MalteP/klingelerweiterung/documentation/belegung.png

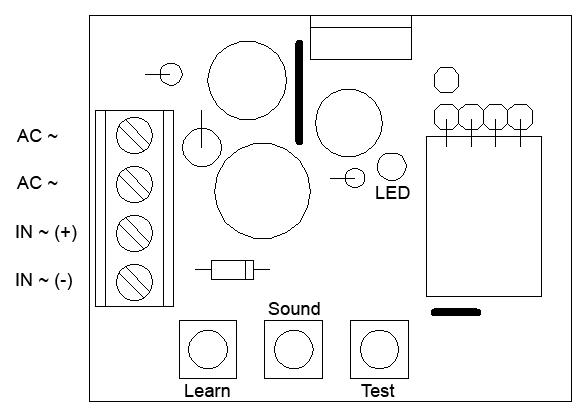
documentation/belegung.png
