MalteP/klingelerweiterung/documentation/Bauteileliste - Klingelerweiterung.ods

Bauteil | Bauteilbezeichnung | Bestellnummer | Distributor | Preis
BR1 | Brückengleichrichter | B40C1500RUND | Reichelt | 0,14 €
C1 | 470µF / 25V | RAD 105 470/63 | Reichelt | 0,17 €
C2 | 100nF SMD 1206 | X7R-G1206 100N | Reichelt | 0,10 €
C3 | 100nF SMD 1206 | X7R-G1206 100N | Reichelt | 0,10 €
C4 | 100µF / 16V | RAD 105 100/35 | Reichelt | 0,04 €
C5 | 100nF SMD 1206 | X7R-G1206 100N | Reichelt | 0,10 €
C6 | 100nF SMD 1206 | X7R-G1206 100N | Reichelt | 0,10 €
C7 | 100nF SMD 1206 | X7R-G1206 100N | Reichelt | 0,10 €
D1 | Zener 1,3W 5,6V | ZD 5,6 | Reichelt | 0,06 €
D2 | P6KE24CA | 543-8450 | RS-Components | 0,81 €
D3 | 1N4007 | 1N 4007 | Reichelt | 0,02 €
D4 | LED blau 3mm | LED 3MM ST BL | Reichelt | 0,58 €
IC1 | MC7805 | TS 7805 CZ | Reichelt | 0,29 €
IC2 | PC357 SMD | PC 357N1TJ00F | Reichelt | 0,32 €
IC3 | ATMega48 | ATMEGA 48A-AU | Reichelt | 1,90 €
IC4 | Sendemodul QAM-TX1 | 617-2072 | RS-Components | 5,75 €
K1 | Schraubklemme 4 fach | AKL 101-04 | Reichelt | 0,39 €
R1 | 680R 1206 | SMD 1/4W 680 | Reichelt | 0,10 €
R2 | 220R 1206 | SMD 1/4W 220 | Reichelt | 0,10 €
R3 | 4,7K 1206 | SMD 1/4W 4,7K | Reichelt | 0,10 €
R4 | 4,7K 1206 | SMD 1/4W 4,7K | Reichelt | 0,10 €
R5 | 4,7K 1206 | SMD 1/4W 4,7K | Reichelt | 0,10 €
R6 | 10R Metallfilm 0,6W | METALL 10,0 | Reichelt | 0,08 € | ← In Schrumpfschlauch, Sicherheitswiderstand!
R7 | 680R 1206 | SMD 1/4W 680 | Reichelt | 0,10 €
R8 | 4,7K 1206 | SMD 1/4W 4,7K | Reichelt | 0,10 €
S1 | Microtaster | TASTER 3301 | Reichelt | 0,10 €
S2 | Microtaster | TASTER 3301 | Reichelt | 0,10 €
S3 | Microtaster | TASTER 3301 | Reichelt | 0,10 €
PCB | Platine | PCB-FUNKGONG | MP | 7,50 €
DB | Distanzbolzen | DI 10MM | Reichelt | 0,40 €
ISO | Isolierscheiben | - | MP | 0,20 € | ← 4 St.
SCH | Schraube M3 | SKL M3X10-50 | Reichelt | 0,20 € | ← 4 St.
 |  |  |  | 20,35 €
