MalteP/klingelerweiterung/documentation/schaltplan.pdf

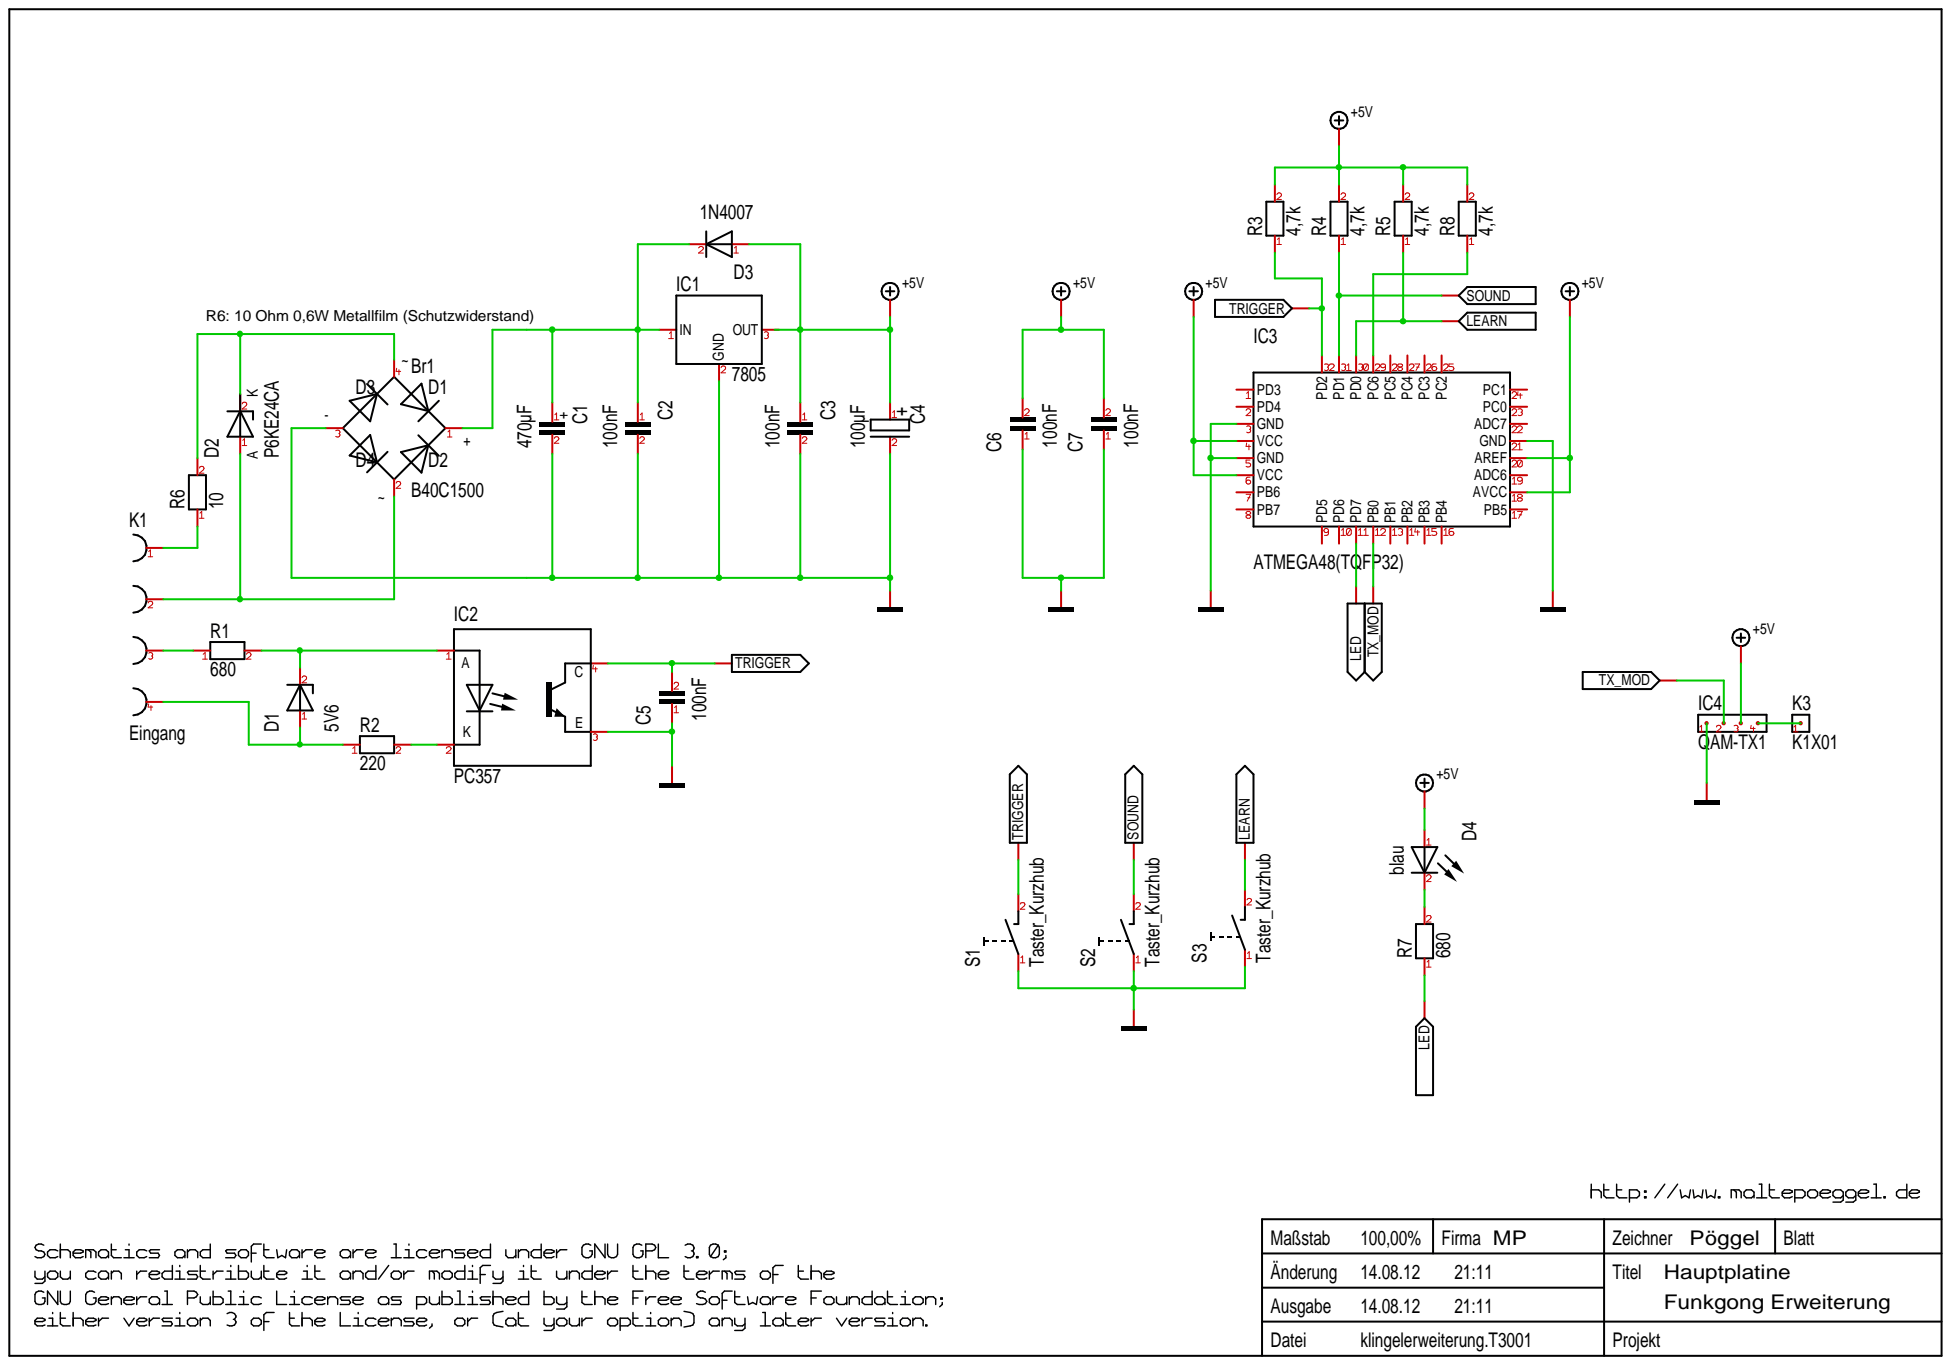
[picture p2: page 1]

Maßstab 100,00% | Firma MP | Zeichner Pöggel | Blatt
Änderung 14.08.12 21:11 | | Titel Hauptplatine Funkgong Erweiterung
