MalteP/klingelerweiterung/(commit log)

2014-05-14 Initial commit version 1.0
    [Bauteileliste - Klingelerweiterung.ods]
2014-05-14 Version 1.2 - No need for permanent power supply anymore. If input is high on power up we will send immediately!
2014-05-14 Added some documentation.
    [Bauteileliste - Klingelerweiterung.ods]
