MalteP/klingelerweiterung/(notices)

Notices in the files:
firmware/main.c:
under the terms of the GNU General Public License as published by the
Free Software Foundation; either version 3 of the License,
or (at your option) any later version.
